ballhog/calyx-level/hardware/calyx-level-carrier/renders/bottom.png

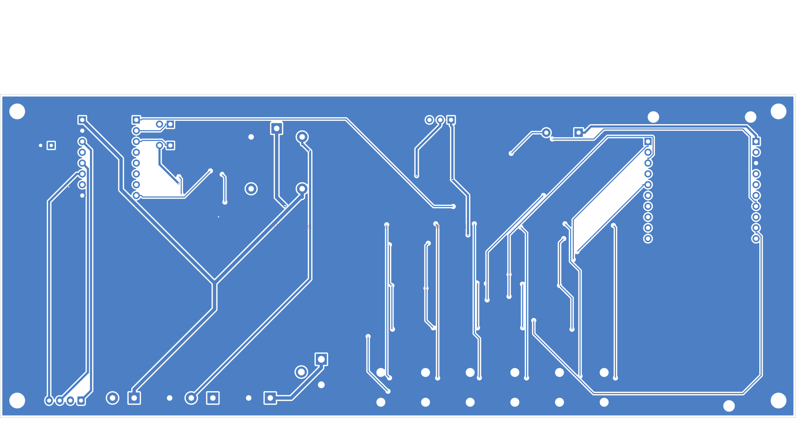
hardware/calyx-level-carrier/renders/bottom.png
