ballhog/calyx-level/hardware/calyx-level-carrier/renders/top.png

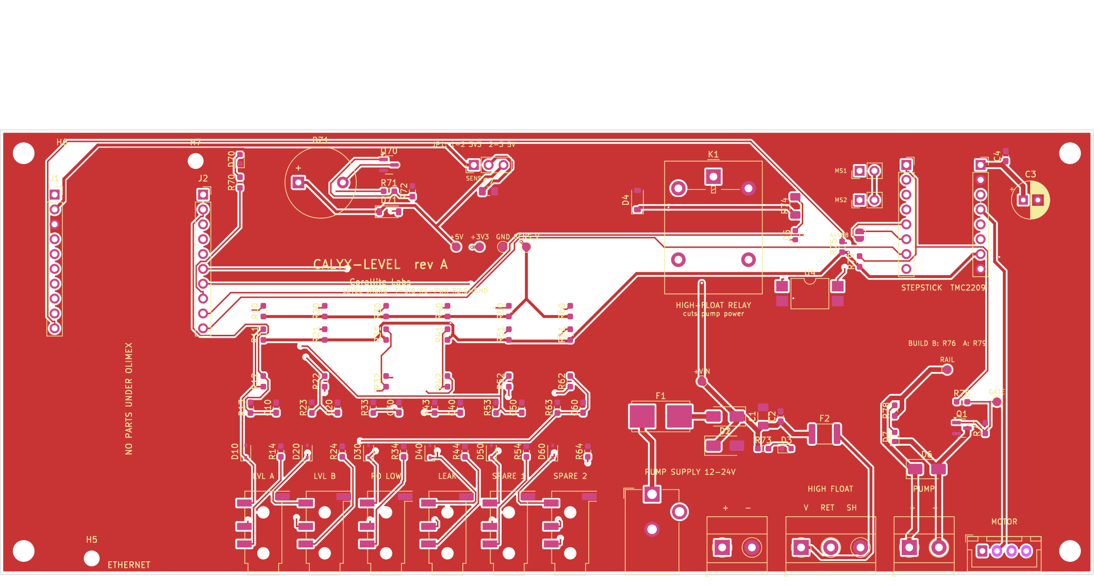
hardware/calyx-level-carrier/renders/top.png
