ballhog/calyx-level/hardware/calyx-level-carrier/calyx-level-carrier.pdf

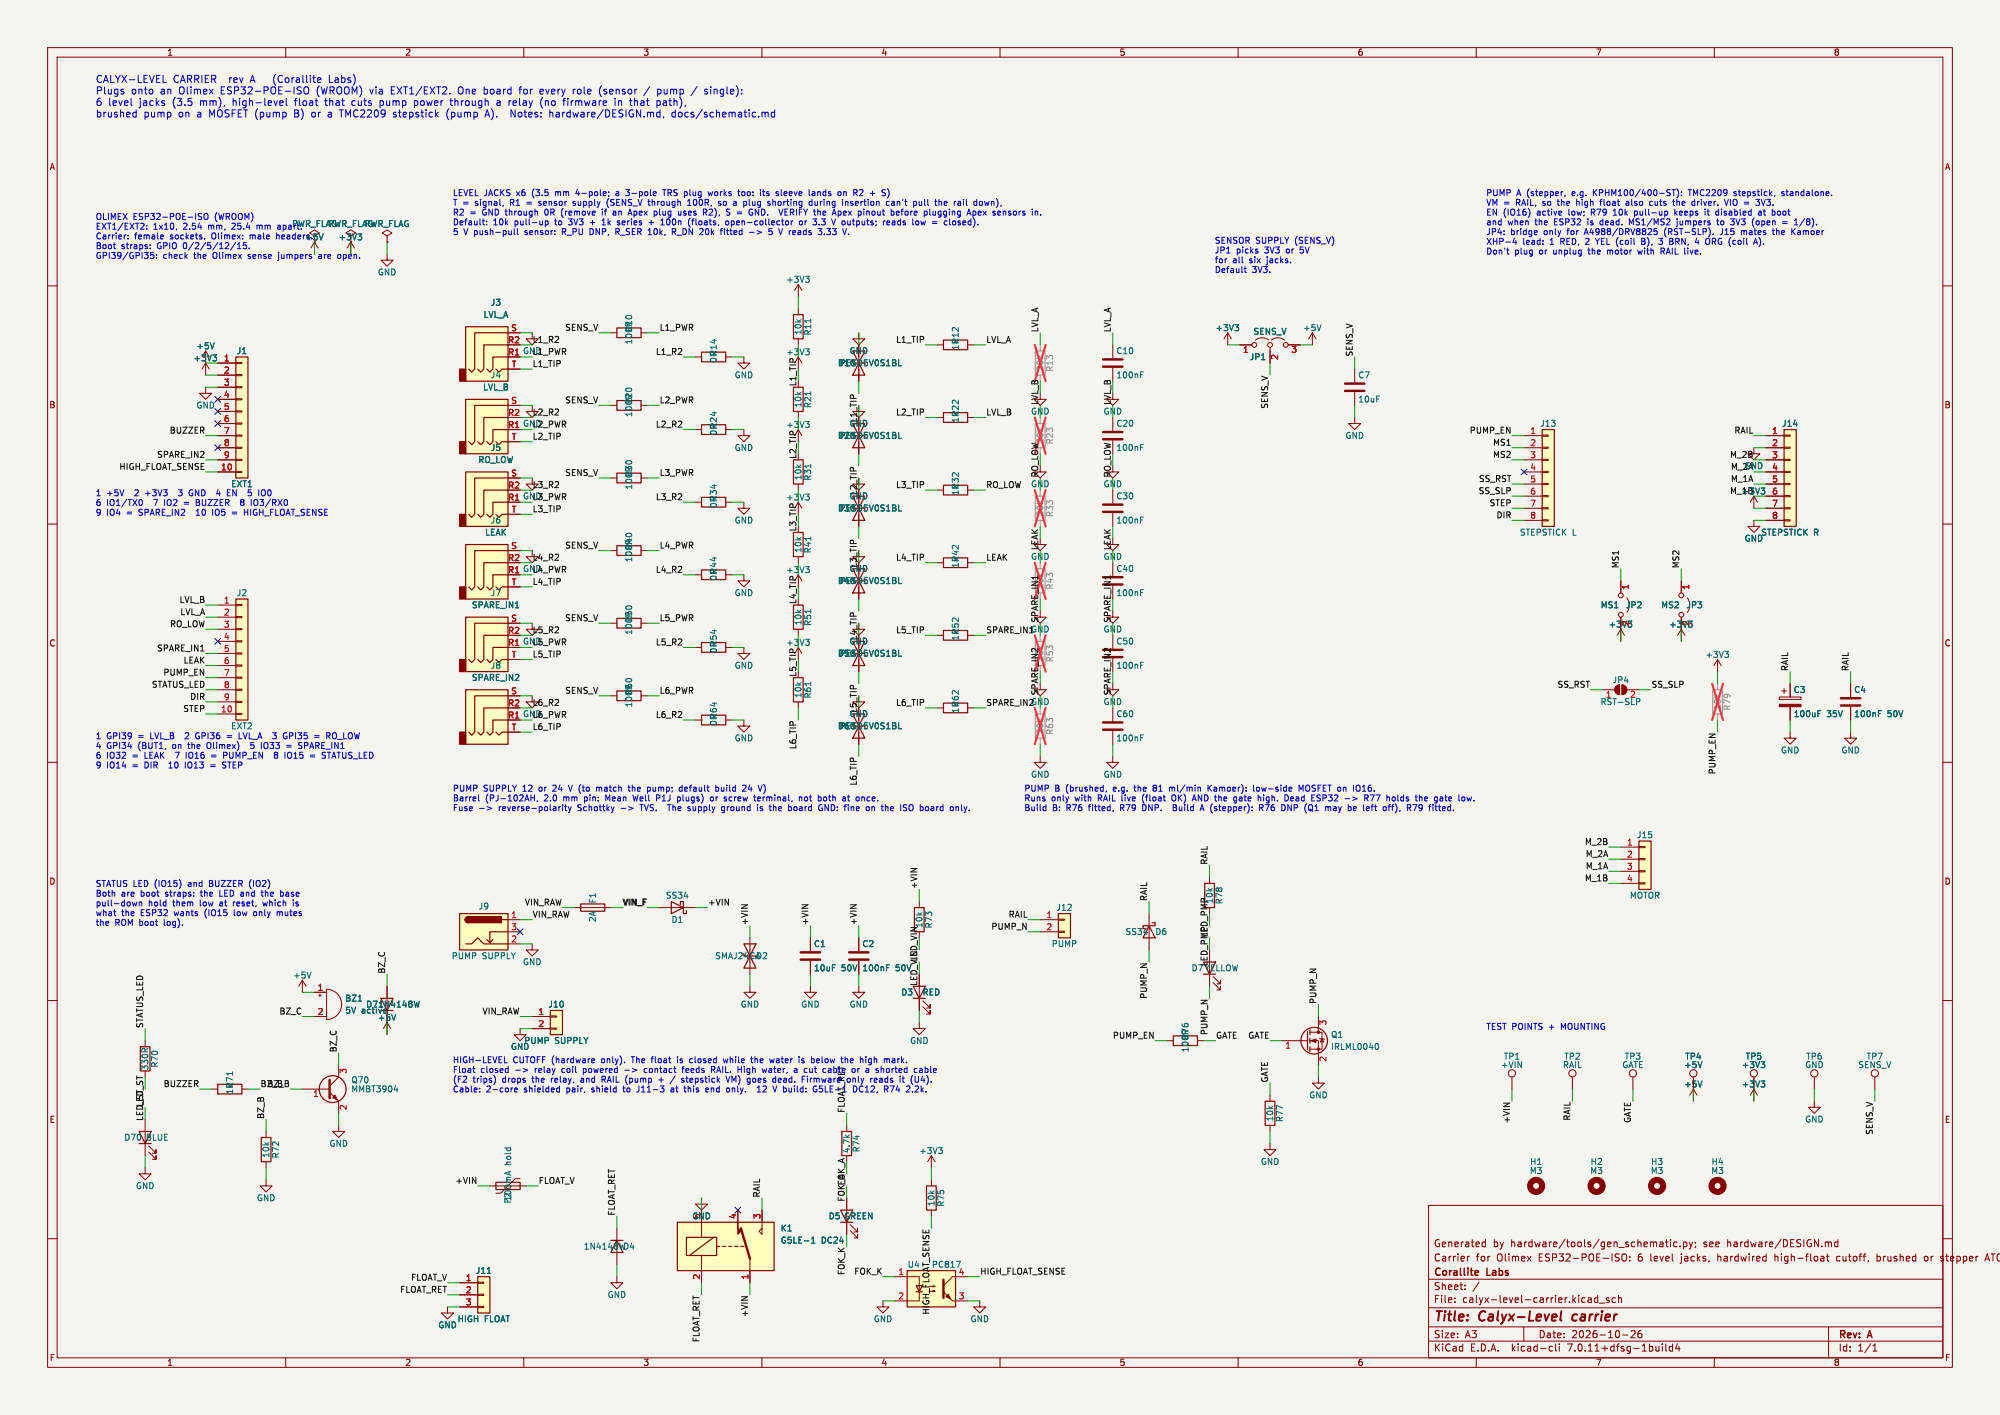
[picture p3: page 1]

SENSOR SUPPLY (SENS_V) JP1 picks 3V3 or 5V

STATUS LED (IO15) and BUZZER (IO2) Both are boot straps: the LED and the base
