ballhog/calyx-level/hardware/calyx-level-carrier/calyx-level-carrier-pcb.pdf

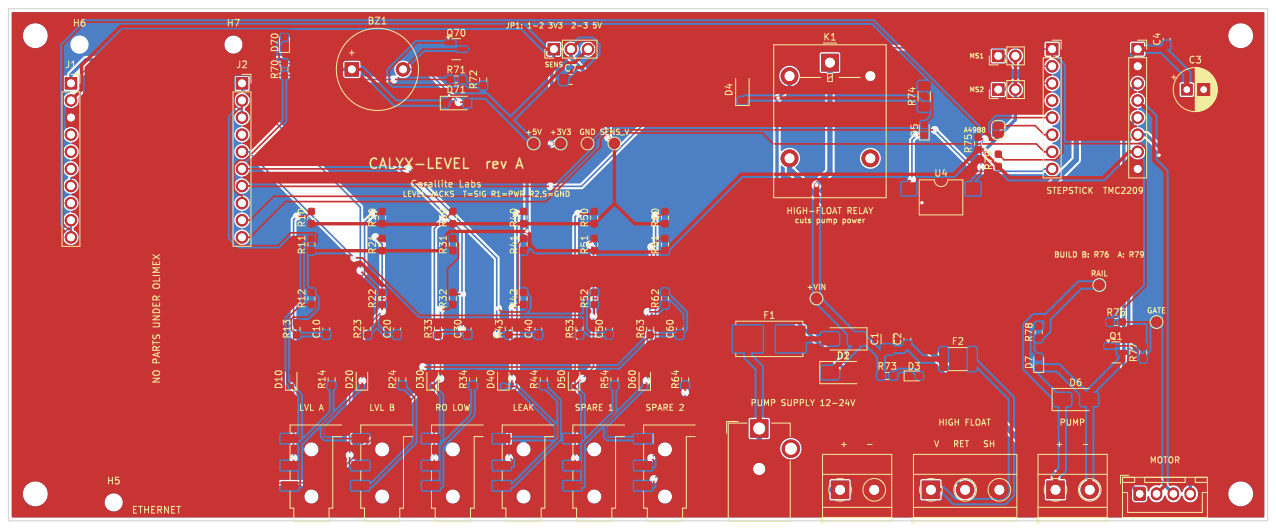
[picture p4: page 1]
