ballhog/calyx-level/hardware/calyx-level-carrier/calyx-level-carrier.kicad_pcb

## KiCad design hardware/calyx-level-carrier/calyx-level-carrier.kicad_pcb (2026-10-26)

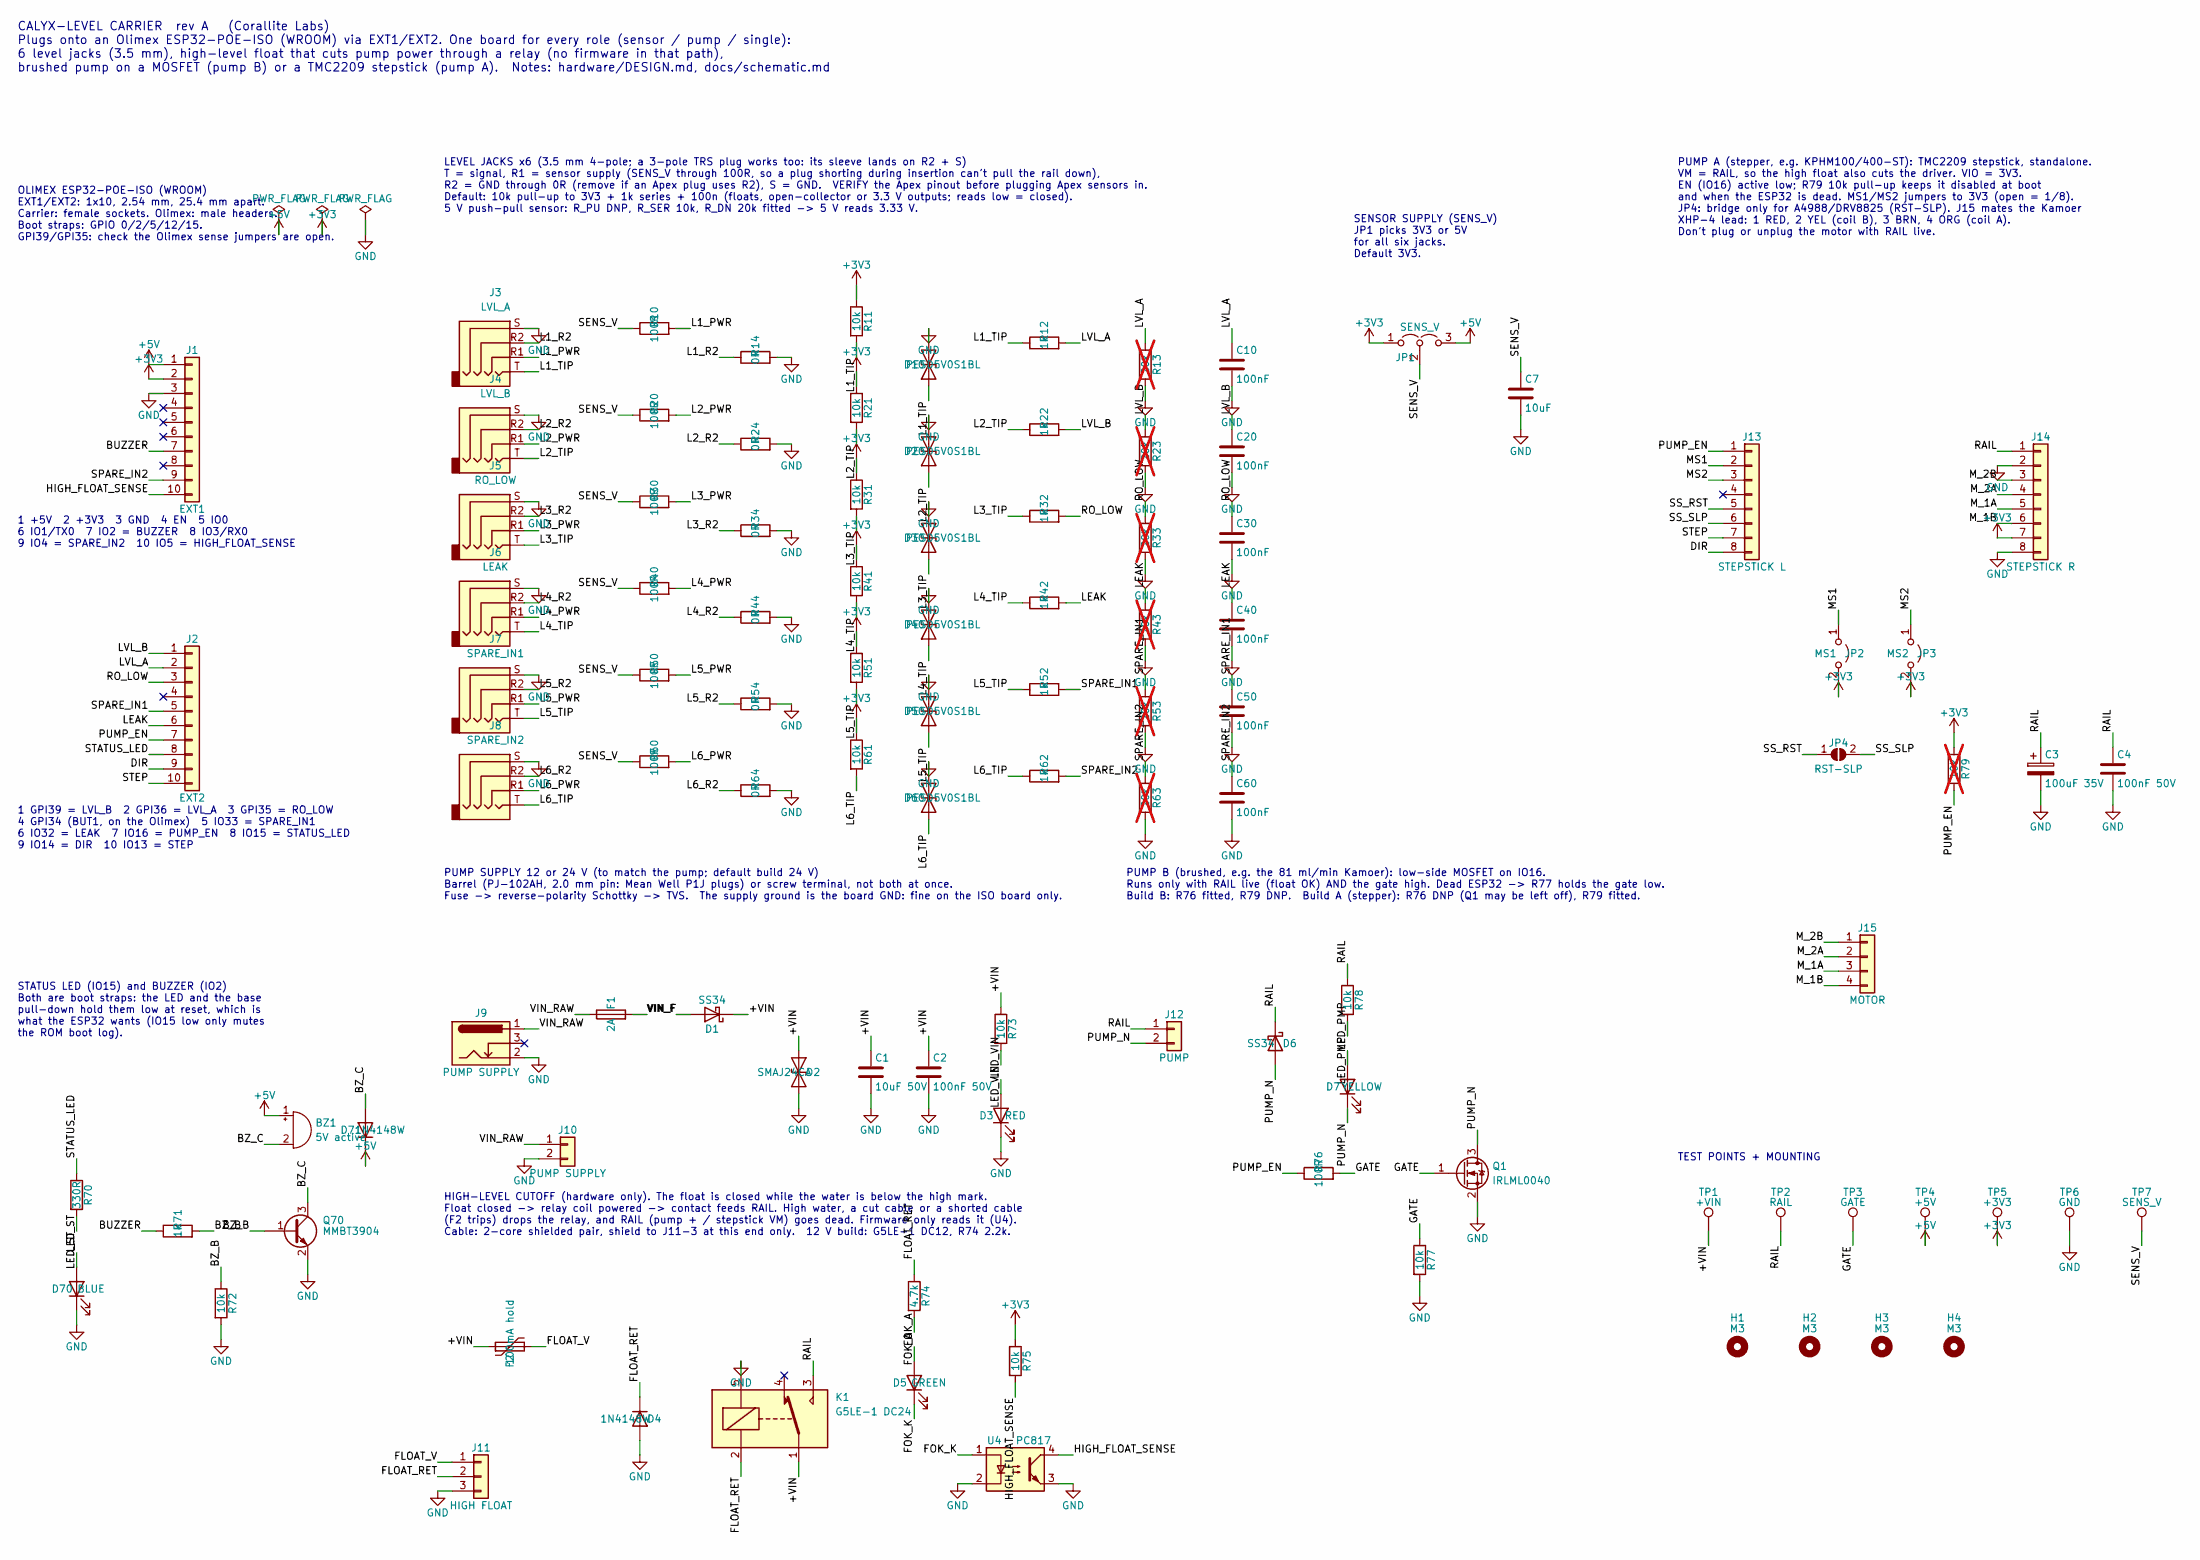
[picture p5: schematic calyx-level-carrier.kicad_sch, Calyx-Level carrier]

Parts:
BZ1: 5V active; Buzzer_12x9.5RM7.6; MPN PUI AI-1223-TWT-5V-2-R (verify: 12 mm, 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
C1: 10uF 50V; C_1206_3216Metric_Pad1.33x1.80mm_HandSolder
C2, C4: 100nF 50V; C_0603_1608Metric_Pad1.08x0.95mm_HandSolder
C3: 100uF 35V; CP_Radial_D6.3mm_P2.50mm
C7: 10uF; C_0805_2012Metric_Pad1.18x1.45mm_HandSolder
C10, C20, C30, C40, C50, C60: 100nF; C_0603_1608Metric_Pad1.08x0.95mm_HandSolder
D1, D6: SS34; D_SMA; MPN SS34
D2: SMAJ24CA; D_SMA; MPN SMAJ24CA
D3: RED; LED_0603_1608Metric
D4, D71: 1N4148W; D_SOD-123
D5: GREEN; LED_0603_1608Metric
D7: YELLOW; LED_0603_1608Metric
D10, D20, D30, D40, D50, D60: PESD5V0S1BL; D_SOD-323; MPN PESD5V0S1BL
D70: BLUE; LED_0603_1608Metric
F1: 2A; Fuseholder_Littelfuse_Nano2_154x; MPN Littelfuse 0154002.DRT holder + 0453002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
F2: 100mA hold; Fuse_1812_4532Metric; MPN Bourns MF-MSMF010-2 (0.1 A, 60 V)
H1, H2, H3, H4: M3; MountingHole_3.2mm_M3
J1: EXT1; PinSocket_1x10_P2.54mm_Vertical
J2: EXT2; PinSocket_1x10_P2.54mm_Vertical
J3: LVL_A; Jack_3.5mm_KoreanHropartsElec_PJ-320D-4A_Horizontal; MPN PJ-320D-4A; LCSC C95562
J4: LVL_B; Jack_3.5mm_KoreanHropartsElec_PJ-320D-4A_Horizontal; MPN PJ-320D-4A; LCSC C95562
J5: RO_LOW; Jack_3.5mm_KoreanHropartsElec_PJ-320D-4A_Horizontal; MPN PJ-320D-4A; LCSC C95562
J6: LEAK; Jack_3.5mm_KoreanHropartsElec_PJ-320D-4A_Horizontal; MPN PJ-320D-4A; LCSC C95562
J7: SPARE_IN1; Jack_3.5mm_KoreanHropartsElec_PJ-320D-4A_Horizontal; MPN PJ-320D-4A; LCSC C95562
J8: SPARE_IN2; Jack_3.5mm_KoreanHropartsElec_PJ-320D-4A_Horizontal; MPN PJ-320D-4A; LCSC C95562
J9: PUMP SUPPLY; BarrelJack_CUI_PJ-102AH_Horizontal; MPN PJ-102AH
J10: PUMP SUPPLY; TerminalBlock_Phoenix_MKDS-1,5-2-5.08_1x02_P5.08mm_Horizont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; MPN MKDS 1,5/2-5,08 (1715721)
J11: HIGH FLOAT; TerminalBlock_Phoenix_MKDS-1,5-3-5.08_1x03_P5.08mm_Horizont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; MPN MKDS 1,5/3-5,08 (1715734)
J12: PUMP; TerminalBlock_Phoenix_MKDS-1,5-2-5.08_1x02_P5.08mm_Horizont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; MPN MKDS 1,5/2-5,08 (1715721)
J13: STEPSTICK L; PinSocket_1x08_P2.54mm_Vertical
J14: STEPSTICK R; PinSocket_1x08_P2.54mm_Vertical
J15: MOTOR; JST_XH_B4B-XH-A_1x04_P2.50mm_Vertical; MPN B4B-XH-A
JP1: SENS_V; PinHeader_1x03_P2.54mm_Vertical
JP2: MS1; PinHeader_1x02_P2.54mm_Vertical
JP3: MS2; PinHeader_1x02_P2.54mm_Vertical
JP4: RST-SLP; SolderJumper-2_P1.3mm_Open_RoundedPad1.0x1.5mm
K1: G5LE-1 DC24; Relay_SPDT_Omron-G5LE-1; MPN G5LE-1 DC24
Q1: IRLML0040; SOT-23; MPN IRLML0040TRPBF
Q70: MMBT3904; SOT-23
R10, R20, R30, R40, R50, R60, R76: 100R; R_0603_1608Metric_Pad0.98x0.95mm_HandSolder
R11, R21, R31, R41, R51, R61, R72, R73, R75, R77, R78: 10k; R_0603_1608Metric_Pad0.98x0.95mm_HandSolder
R12, R22, R32, R42, R52, R62, R71: 1k; R_0603_1608Metric_Pad0.98x0.95mm_HandSolder
R13, R23, R33, R43, R53, R63: 20k; R_0603_1608Metric_Pad0.98x0.95mm_HandSolder; not fitted
R14, R24, R34, R44, R54, R64: 0R; R_0603_1608Metric_Pad0.98x0.95mm_HandSolder
R70: 330R; R_0603_1608Metric_Pad0.98x0.95mm_HandSolder
R74: 4.7k; R_1206_3216Metric_Pad1.30x1.75mm_HandSolder
R79: 10k; R_0603_1608Metric_Pad0.98x0.95mm_HandSolder; not fitted
TP1: +VIN; TestPoint_Pad_D1.5mm
TP2: RAIL; TestPoint_Pad_D1.5mm
TP3: GATE; TestPoint_Pad_D1.5mm
TP4: +5V; TestPoint_Pad_D1.5mm
TP5: +3V3; TestPoint_Pad_D1.5mm
TP6: GND; TestPoint_Pad_D1.5mm
TP7: SENS_V; TestPoint_Pad_D1.5mm
U4: PC817; SMDIP-4_W9.53mm; MPN PC817 SMD gull-wing (verify lead span)

Connections:
+3V3: J1.2, J14.7, JP1.1 (A), JP2.2 (B), JP3.2 (B), R11.1, R21.1, R31.1, R41.1, R51.1, R61.1, R75.1, R79.1, TP5.1
+5V: BZ1.1 (+), D71.1 (K), J1.1, JP1.3 (B), TP4.1
/+VIN: C1.1, C2.1, D1.1 (K), D2.1 (A1), F2.1, K1.1, R73.1, TP1.1
/BUZZER: J1.7, R71.1
/BZ_B: Q70.1 (B), R71.2, R72.1
/BZ_C: BZ1.2 (-), D71.2 (A), Q70.3 (C)
/DIR: J2.9, J13.8
/FLOAT_RET: D4.1 (K), J11.2, K1.2, R74.1
/FLOAT_V: F2.2, J11.1
/FOK_A: D5.2 (A), R74.2
/FOK_K: D5.1 (K), U4.1
/GATE: Q1.1 (G), R76.2, R77.1, TP3.1
/HIGH_FLOAT_SENSE: J1.10, R75.2, U4.4
/L1_PWR: J3.R1, R10.2
/L1_R2: J3.R2, R14.1
/L1_TIP: D10.1 (A1), J3.T, R11.2, R12.1
/L2_PWR: J4.R1, R20.2
/L2_R2: J4.R2, R24.1
/L2_TIP: D20.1 (A1), J4.T, R21.2, R22.1
/L3_PWR: J5.R1, R30.2
/L3_R2: J5.R2, R34.1
/L3_TIP: D30.1 (A1), J5.T, R31.2, R32.1
/L4_PWR: J6.R1, R40.2
/L4_R2: J6.R2, R44.1
/L4_TIP: D40.1 (A1), J6.T, R41.2, R42.1
/L5_PWR: J7.R1, R50.2
/L5_R2: J7.R2, R54.1
/L5_TIP: D50.1 (A1), J7.T, R51.2, R52.1
/L6_PWR: J8.R1, R60.2
/L6_R2: J8.R2, R64.1
/L6_TIP: D60.1 (A1), J8.T, R61.2, R62.1
/LEAK: C40.1, J2.6, R42.2, R43.1
/LED_PMP: D7.2 (A), R78.2
/LED_ST: D70.2 (A), R70.2
/LED_VIN: D3.2 (A), R73.2
/LVL_A: C10.1, J2.2, R12.2, R13.1
/LVL_B: C20.1, J2.1, R22.2, R23.1
/MS1: J13.2, JP2.1 (A)
/MS2: J13.3, JP3.1 (A)
/M_1A: J14.5, J15.3
/M_1B: J14.6, J15.4
/M_2A: J14.4, J15.2
/M_2B: J14.3, J15.1
/PUMP_EN: J2.7, J13.1, R76.1, R79.2
/PUMP_N: D6.2 (A), D7.1 (K), J12.2, Q1.3 (D)
/RAIL: C3.1, C4.1, D6.1 (K), J12.1, J14.1, K1.3, R78.1, TP2.1
/RO_LOW: C30.1, J2.3, R32.2, R33.1
/SENS_V: C7.1, JP1.2 (C), R10.1, R20.1, R30.1, R40.1, R50.1, R60.1, TP7.1
/SPARE_IN1: C50.1, J2.5, R52.2, R53.1
/SPARE_IN2: C60.1, J1.9, R62.2, R63.1
/SS_RST: J13.5, JP4.1 (A)
/SS_SLP: J13.6, JP4.2 (B)
/STATUS_LED: J2.8, R70.1
/STEP: J2.10, J13.7
/VIN_F: D1.2 (A), F1.2
/VIN_RAW: F1.1, J9.1, J10.1
GND: C1.2, C2.2, C3.2, C4.2, C7.2, C10.2, C20.2, C30.2, C40.2, C50.2, C60.2, D2.2 (A2), D3.1 (K), D4.2 (A), D10.2 (A2), D20.2 (A2), D30.2 (A2), D40.2 (A2), D50.2 (A2), D60.2 (A2), D70.1 (K), J1.3, J3.S, J4.S, J5.S, J6.S, J7.S, J8.S, J9.2, J10.2, J11.3, J14.2, J14.8, K1.5, Q1.2 (S), Q70.2 (E), R13.2, R14.2, R23.2, R24.2, R33.2, R34.2, R43.2, R44.2, R53.2, R54.2, R63.2, R64.2, R72.2, R77.2, TP6.1, U4.2, U4.3

Notes on the sheet:
CALYX-LEVEL CARRIER rev A (Corallite Labs) Plugs onto an Olimex ESP32-POE-ISO (WROOM) via EXT1/EXT2. One board for every role (sensor / pump / single): 6 level jacks (3.5 mm), high-level float that cuts pump power through a relay (no firmware in that path), brushed pump on a MOSFET (pump B) or a TM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
OLIMEX ESP32-POE-ISO (WROOM) EXT1/EXT2: 1x10, 2.54 mm, 25.4 mm apart. Carrier: female sockets. Olimex: male headers. Boot straps: GPIO 0/2/5/12/15. GPI39/GPI35: check the Olimex sense jumpers are open.
1 +5V 2 +3V3 3 GND 4 EN 5 IO0 6 IO1/TX0 7 IO2 = BUZZER 8 IO3/RX0 9 IO4 = SPARE_IN2 10 IO5 = HIGH_FLOAT_SENSE
1 GPI39 = LVL_B 2 GPI36 = LVL_A 3 GPI35 = RO_LOW 4 GPI34 (BUT1, on the Olimex) 5 IO33 = SPARE_IN1 6 IO32 = LEAK 7 IO16 = PUMP_EN 8 IO15 = STATUS_LED 9 IO14 = DIR 10 IO13 = STEP
LEVEL JACKS x6 (3.5 mm 4-pole; a 3-pole TRS plug works too: its sleeve lands on R2 + S) T = signal, R1 = sensor supply (SENS_V through 100R, so a plug shorting during insertion can't pull the rail down), R2 = GND through 0R (remove if an Apex plug uses R2), S = GND. VERIFY the Apex pinout before pl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
SENSOR SUPPLY (SENS_V) JP1 picks 3V3 or 5V for all six jacks. Default 3V3.
STATUS LED (IO15) and BUZZER (IO2) Both are boot straps: the LED and the base pull-down hold them low at reset, which is what the ESP32 wants (IO15 low only mutes the ROM boot log).
PUMP SUPPLY 12 or 24 V (to match the pump; default build 24 V) Barrel (PJ-102AH, 2.0 mm pin: Mean Well P1J plugs) or screw terminal, not both at once. Fuse -> reverse-polarity Schottky -> TVS. The supply ground is the board GND: fine on the ISO board only.
HIGH-LEVEL CUTOFF (hardware only). The float is closed while the water is below the high mark. Float closed -> relay coil powered -> contact feeds RAIL. High water, a cut cable or a shorted cable (F2 trips) drops the relay, and RAIL (pump + / stepstick VM) goes dead. Firmware only reads it (U4). Ca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
PUMP B (brushed, e.g. the 81 ml/min Kamoer): low-side MOSFET on IO16. Runs only with RAIL live (float OK) AND the gate high. Dead ESP32 -> R77 holds the gate low. Build B: R76 fitted, R79 DNP. Build A (stepper): R76 DNP (Q1 may be left off), R79 fitted.
PUMP A (stepper, e.g. KPHM100/400-ST): TMC2209 stepstick, standalone. VM = RAIL, so the high float also cuts the driver. VIO = 3V3. EN (IO16) active low; R79 10k pull-up keeps it disabled at boot and when the ESP32 is dead. MS1/MS2 jumpers to 3V3 (open = 1/8). JP4: bridge only for A4988/DRV8825 (RS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
TEST POINTS + MOUNTING

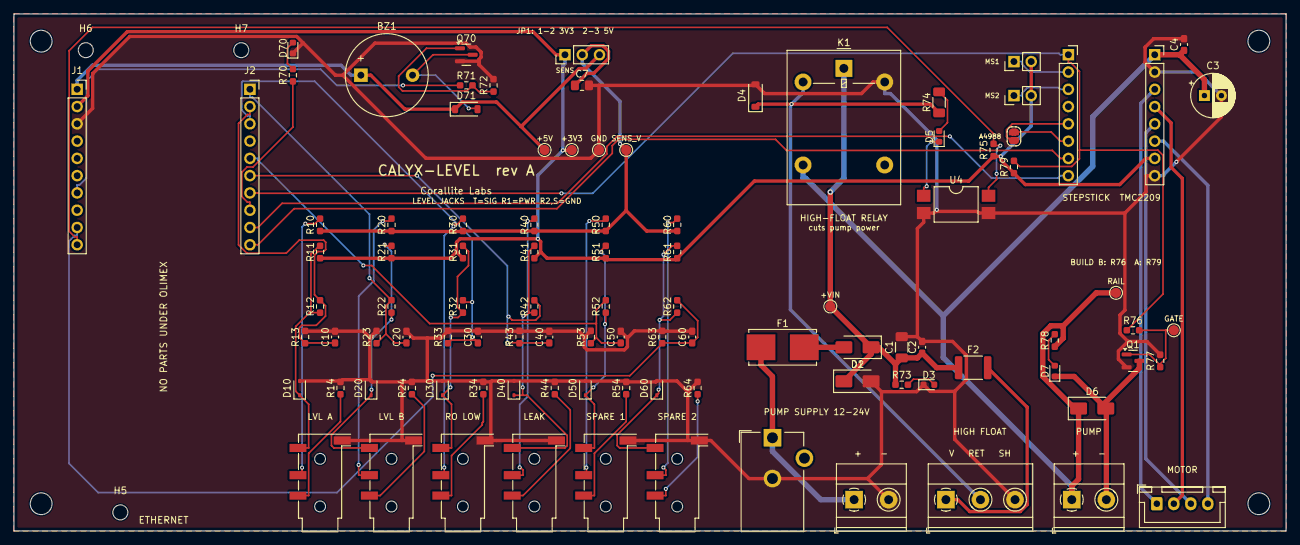
[picture p6: board calyx-level-carrier.kicad_pcb from above]

Board: 2 copper layers, 187.0 x 76.0 mm, 106 parts (0 on the bottom side), 57 nets.

Other parts of the board:
H5: Olimex MH1 standoff; MountingHole_2.2mm_M2
H6: Olimex MH2 standoff; MountingHole_2.2mm_M2
H7: Olimex MH3 standoff; MountingHole_2.2mm_M2
