ballhog/calyx-level/(commit log)

2026-10-23 Design docs: parts, how it works, schematic, Coeno provisioning
    Wired fail-safe ATO: sensor node grants short leases to a pump node over
    Ethernet; pump node enforces its own caps; hardwired high float cuts pump
    power. Olimex ESP32-POE-ISO on a blank Uno carrier with a frozen pin map.
    Coeno serves firmware at /firmware/calyx-level/ (Coeno b9fa573).
    Claude-Session: https://claude.ai/code/session_01LsLWQukpdnZrdY8htus5ya
2026-10-26 Carrier rev A: schematic, project rules and generator tools
    KiCad carrier for the v1 pin map in docs/schematic.md: 6 level jacks,
    relay high-float cutoff in series with pump power, brushed (MOSFET) or
    stepper (stepstick) pump. Tools adapted from calyx-flow. Board to follow.
    Claude-Session: https://claude.ai/code/session_01CW2aCAGa6SDDGYjLuKU4F5
    [calyx-level-carrier.kicad_sch]
2026-10-26 Carrier: pump clearance in the net class, J12/J15 spacing, routing tweaks
    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
    [gen_pcb.py, route_pcb.py]
2026-10-26 Ignore Freerouting logs and KiCad backups
    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
2026-10-26 Carrier rev A: routed board, DRC copper-clean, fab outputs and renders
    Freerouting 60 passes: 704 segments, 51 vias, no copper errors or
    unconnected items (silk warnings only). Gerbers/BOM/CPL in fab/.
    Checks before ordering are listed in hardware/DESIGN.md.
    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
    [calyx-level-carrier-B_Cu.gbl, calyx-level-carrier-B_Mask.gbs, calyx-level-carrier-B_Paste.gbp, calyx-level-carrier-B_Silkscreen.gbo, calyx-level-carrier-Edge_Cuts.gm1, calyx-level-carrier-F_Cu.gtl, calyx-level-carrier-F_Mask.gts, calyx-level-carrier-F_Paste.gtp]
